Ian-Blockmans/ESPHhome-AIO/1708732876486-708fb2fa-5da7-418b-8b6d-8f5f56bf0609_6.jpg

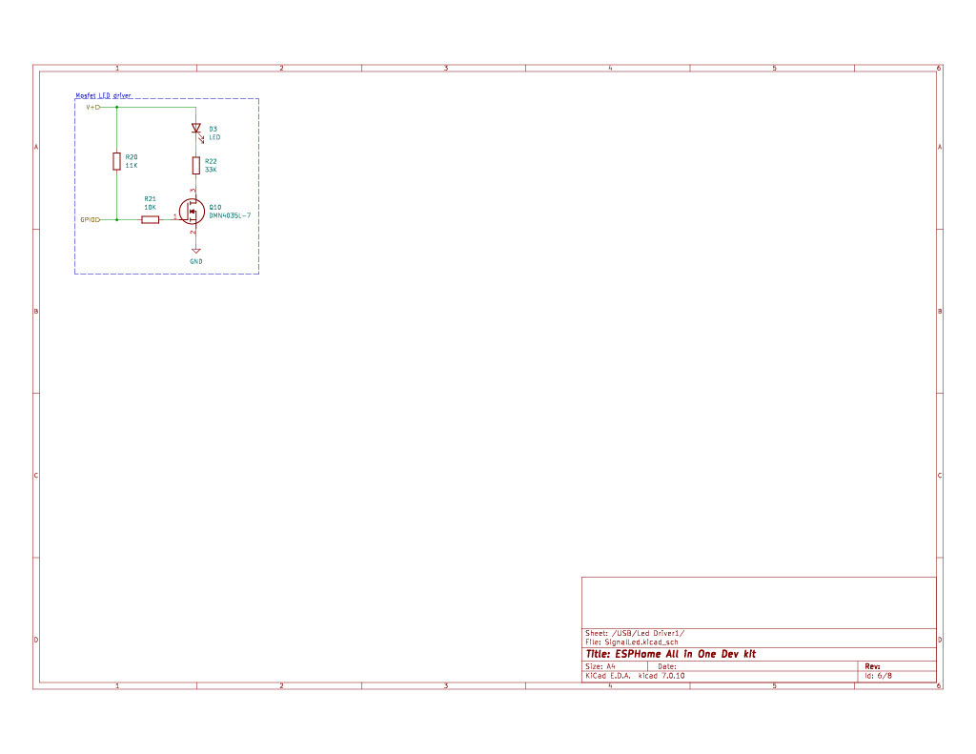
1708732876486-708fb2fa-5da7-418b-8b6d-8f5f56bf0609_6.jpg
