Ian-Blockmans/ESPHhome-AIO/fan-headers.jpg

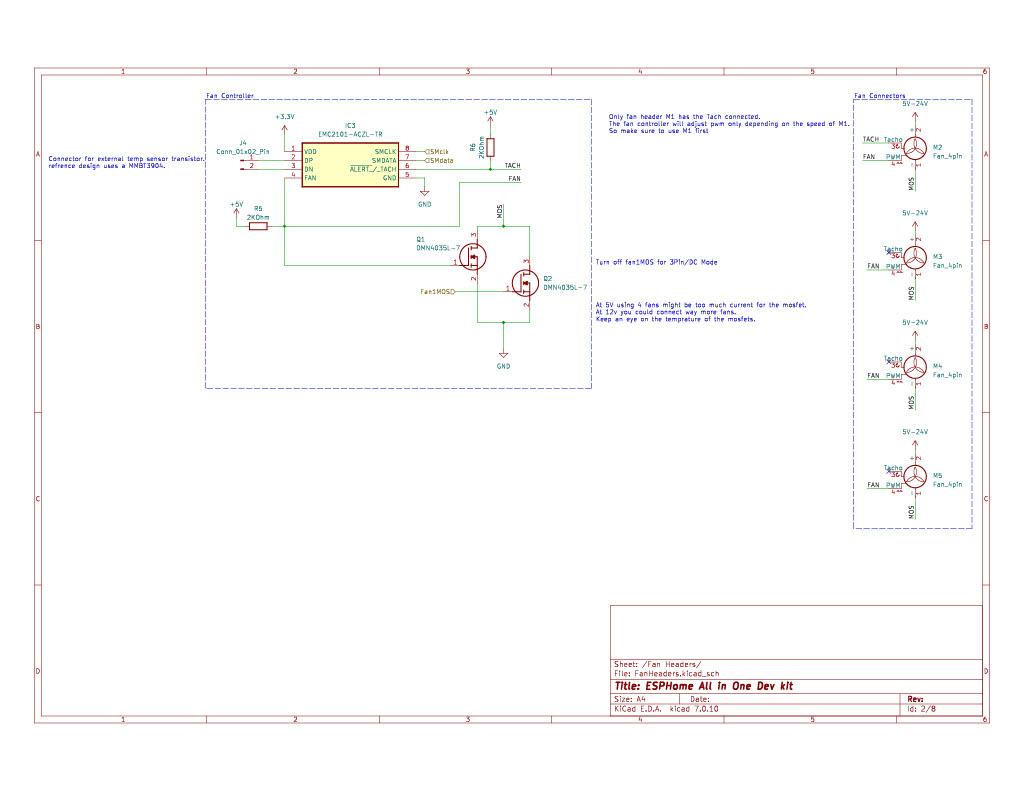
fan-headers.jpg
