Ian-Blockmans/ESPHhome-AIO/rgb.jpg

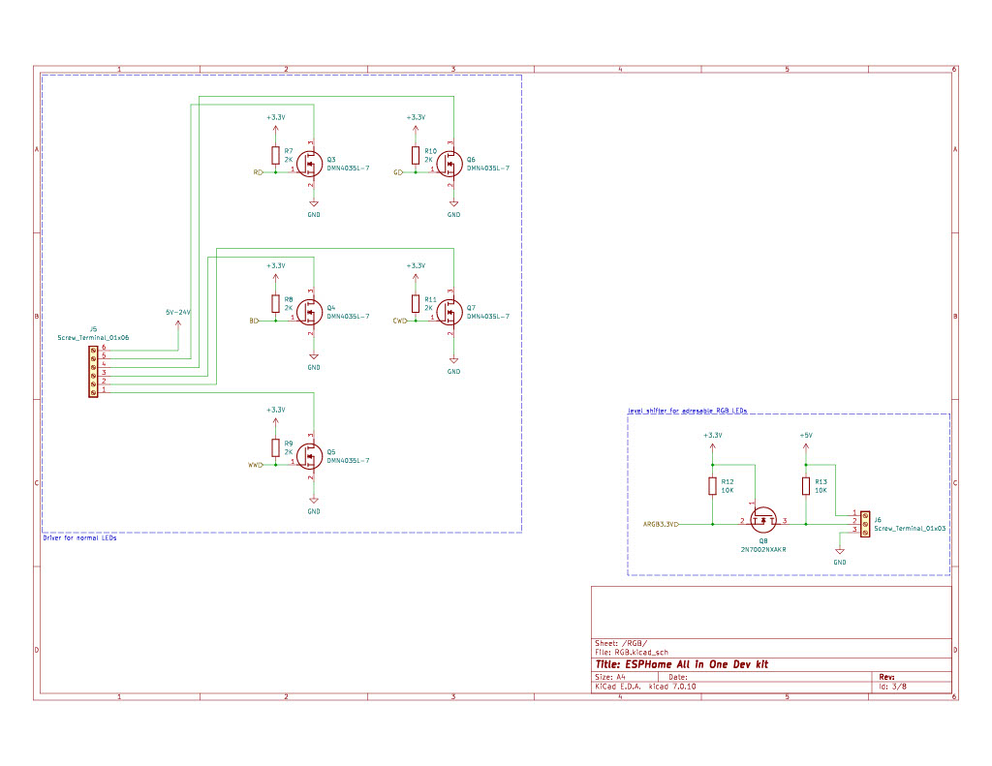
rgb.jpg
