Ian-Blockmans/ESPHhome-AIO/root.jpg

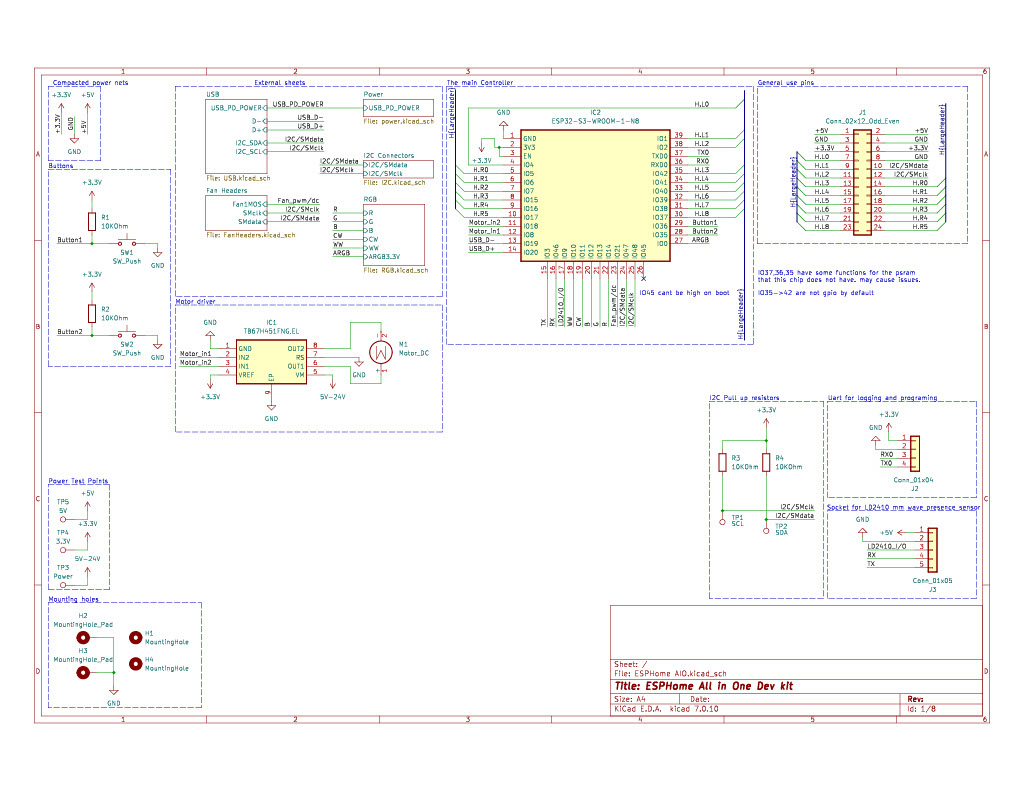
root.jpg
