Ian-Blockmans/ESPHhome-AIO/usb-c.jpg

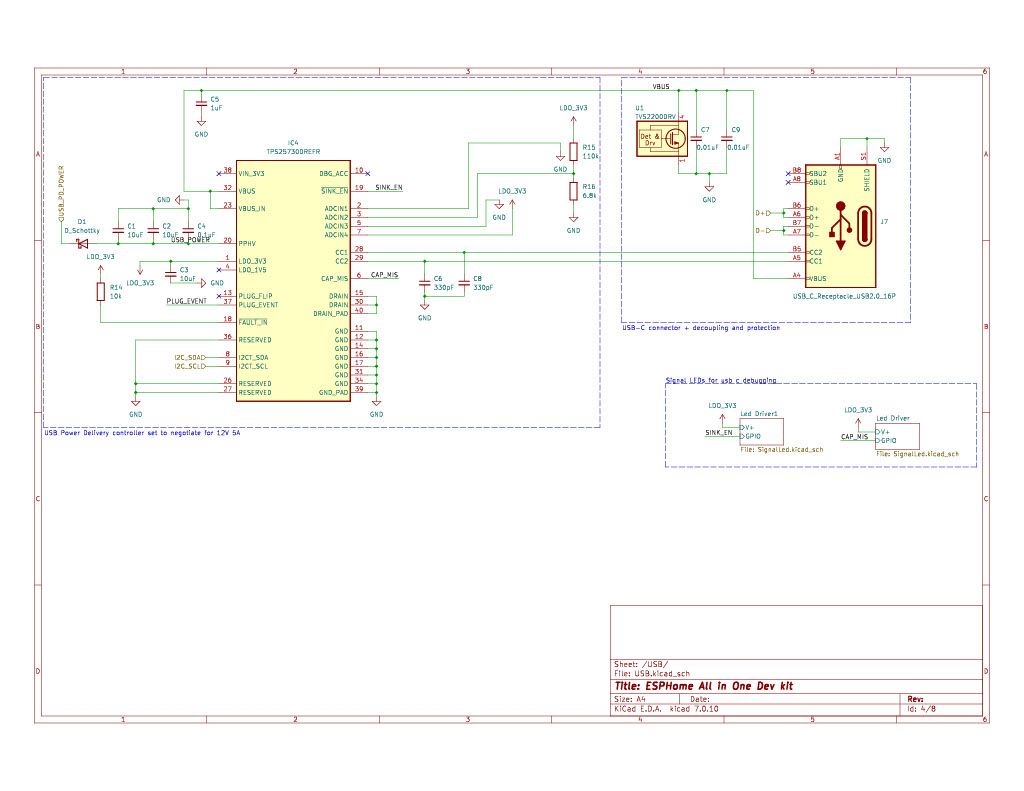
usb-c.jpg
