Ian-Blockmans/ESPHhome-AIO/KiCad Schematics and pcb/ESPHome AIO.kicad_pcb

## KiCad design KiCad Schematics and pcb/ESPHome AIO.kicad_pcb (2024-07-17)

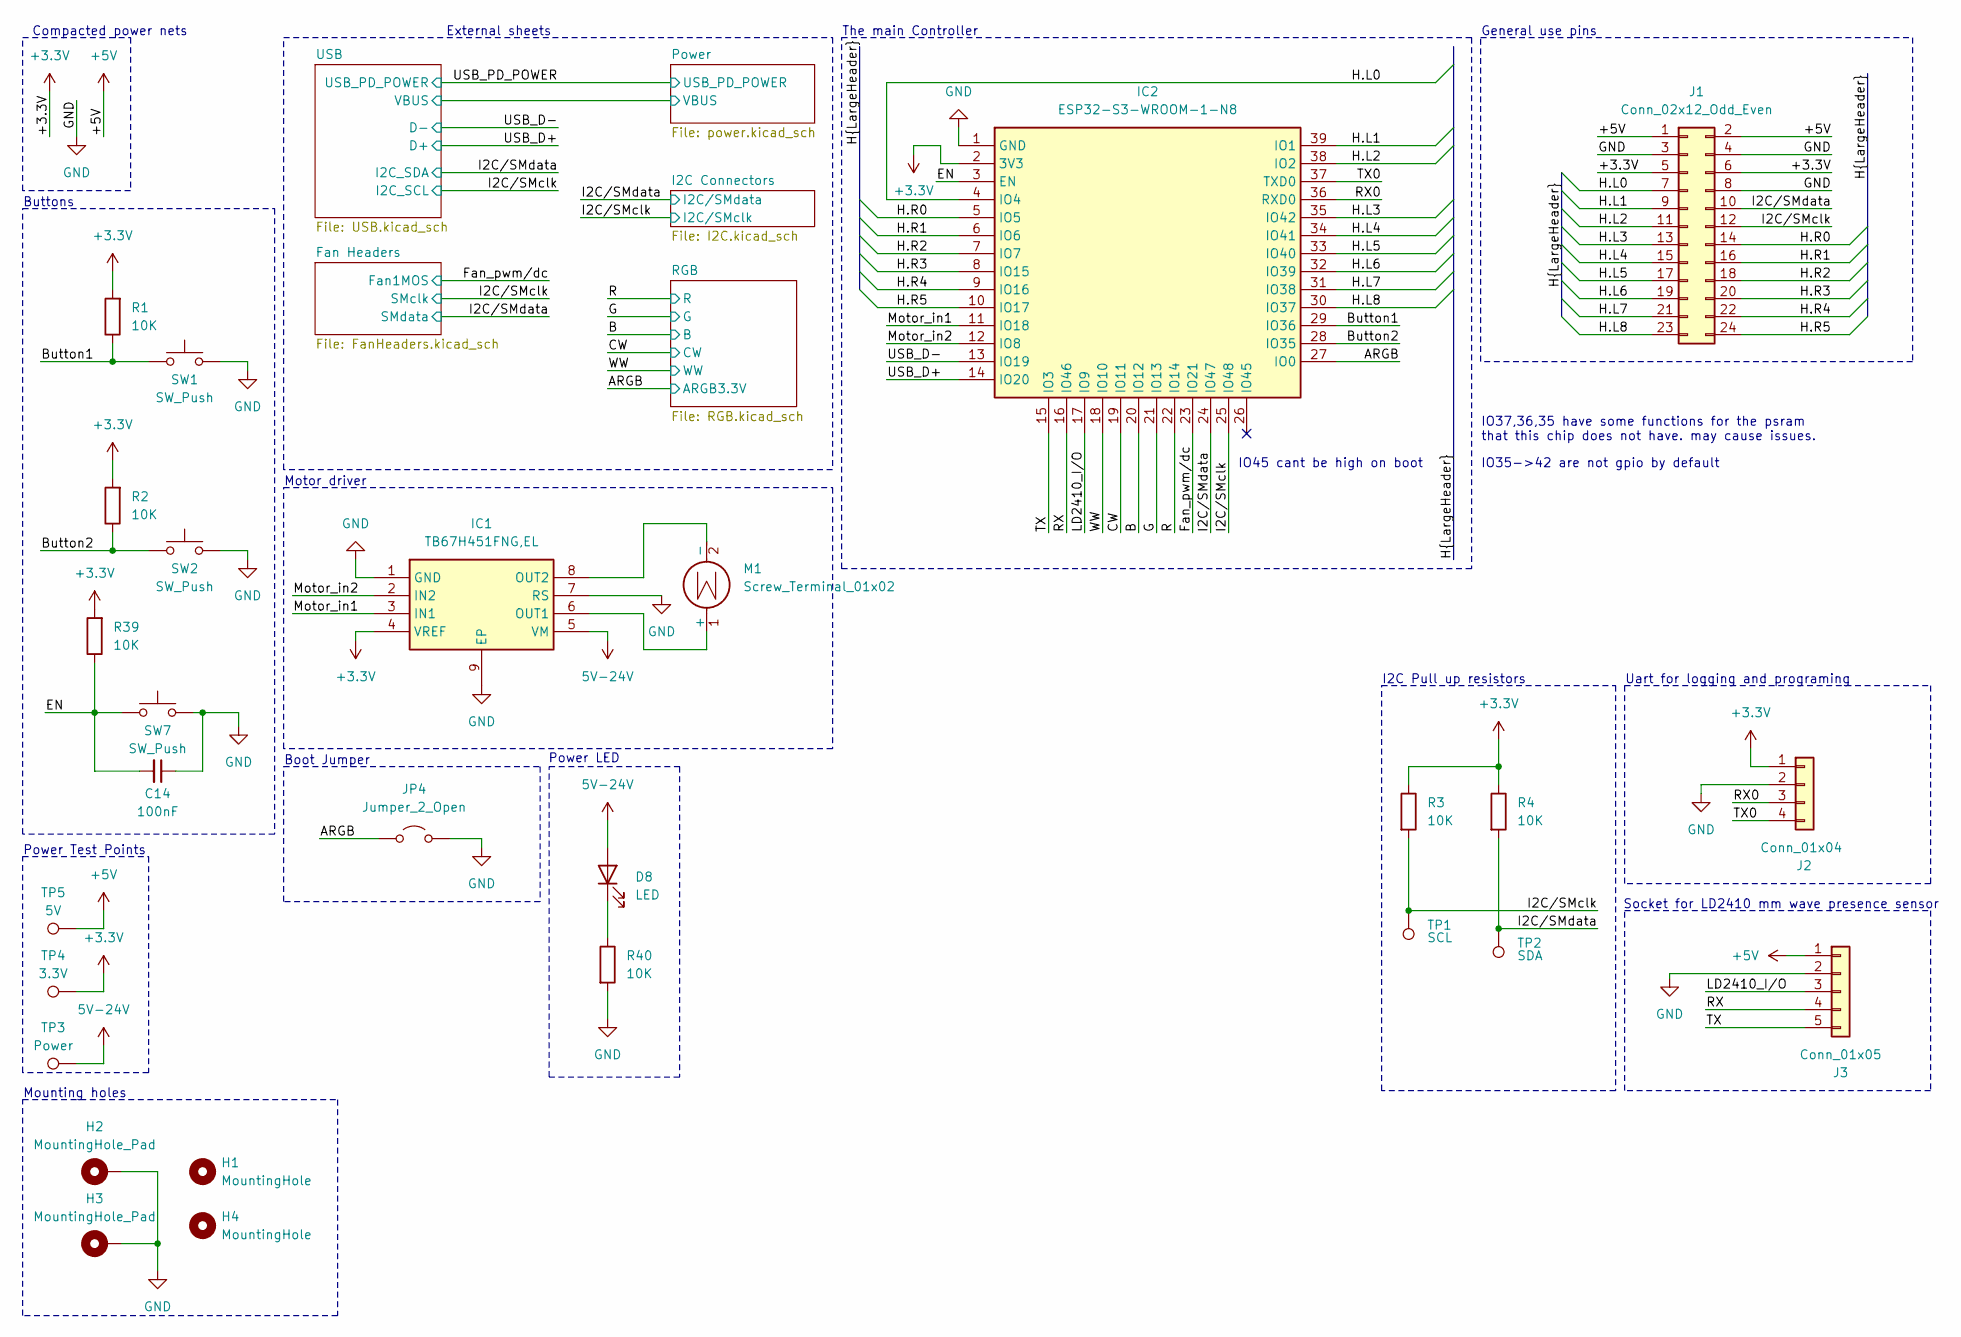
[picture p24: schematic ESPHome AIO.kicad_sch, ESPHome All in One Dev kit]

Parts:
C14: 100nF; C_0805_2012Metric
D8: LED; LED_0805_2012Metric
H1, H4: MountingHole; MountingHole_4.3mm_M4
H2, H3: MountingHole_Pad; MountingHole_4.3mm_M4_Pad
IC1: TB67H451FNG,EL; SOIC127P600X170-9N; Manufacturer_Part_Number TB67H451FNG,EL; Mouser Part Number 757-TB67H451FNGEL
IC2: ESP32-S3-WROOM-1-N8; ESP32S3WROOM1N8R8; Manufacturer_Part_Number ESP32-S3-WROOM-1-N8R8; Mouser Part Number 356-EP32S3WROOM1N8R8
J1: Conn_02x12_Odd_Even; PinHeader_2x12_P2.54mm_Vertical; LCSC C5383110
J2: Conn_01x04; PinHeader_1x04_P2.54mm_Vertical; LCSC C6332197
J3: Conn_01x05; PinHeader_1x05_P2.54mm_Vertical; LCSC C2935899
JP4: Jumper_2_Open; PinHeader_1x02_P2.54mm_Vertical
M1: Screw_Terminal_01x02; PhoenixContact_MSTBA_2,5_2-G-5,08_1x02_P5.08mm_Horizontal; LCSC C8383
R1, R2, R3, R4, R39, R40: 10K; R_0805_2012Metric; LCSC C17414
SW1, SW2, SW7: SW_Push; SW_PUSH_6mm_H7.3mm; LCSC C7463311
TP1: SCL; TestPoint_Loop_D2.60mm_Drill1.4mm_Beaded
TP2: SDA; TestPoint_Loop_D2.60mm_Drill1.4mm_Beaded
TP3: Power; TestPoint_Loop_D2.60mm_Drill1.4mm_Beaded
TP4: 3.3V; TestPoint_Loop_D2.60mm_Drill1.4mm_Beaded
TP5: 5V; TestPoint_Loop_D2.60mm_Drill1.4mm_Beaded

Connections:
5V-24V: D8.2 (A), IC1.5 (VM), TP3.1; also elsewhere on the board
+3.3V: IC1.4 (VREF), IC2.2 (3V3), J1.5, J1.6, J2.1, R1.2, R2.2, R3.1, R4.1, R39.2, TP4.1; also elsewhere on the board
+5V: J1.1, J1.2, J3.1, TP5.1; also elsewhere on the board
/ARGB: IC2.27 (IO0), JP4.1 (A); also elsewhere on the board
/B: IC2.20 (IO12); also elsewhere on the board
/Button1: IC2.29 (IO36), R1.1, SW1.1
/Button2: IC2.28 (IO35), R2.1, SW2.1
/CW: IC2.19 (IO11); also elsewhere on the board
/EN: C14.2, IC2.3 (EN), R39.1, SW7.1
/Fan_pwm/dc: IC2.23 (IO21); also elsewhere on the board
/G: IC2.21 (IO13); also elsewhere on the board
/H.L0: IC2.4 (IO4), J1.7
/H.L1: IC2.39 (IO1), J1.9
/H.L2: IC2.38 (IO2), J1.11
/H.L3: IC2.35 (IO42), J1.13
/H.L4: IC2.34 (IO41), J1.15
/H.L5: IC2.33 (IO40), J1.17
/H.L6: IC2.32 (IO39), J1.19
/H.L7: IC2.31 (IO38), J1.21
/H.L8: IC2.30 (IO37), J1.23
/H.R0: IC2.5 (IO5), J1.14
/H.R1: IC2.6 (IO6), J1.16
/H.R2: IC2.7 (IO7), J1.18
/H.R3: IC2.8 (IO15), J1.20
/H.R4: IC2.9 (IO16), J1.22
/H.R5: IC2.10 (IO17), J1.24
/I2C/SMclk: IC2.25 (IO48), J1.12, R3.2, TP1.1; also elsewhere on the board
/I2C/SMdata: IC2.24 (IO47), J1.10, R4.2, TP2.1; also elsewhere on the board
/LD2410_I/O: IC2.17 (IO9), J3.3
/Motor_in1: IC1.3 (IN1), IC2.11 (IO18)
/Motor_in2: IC1.2 (IN2), IC2.12 (IO8)
/R: IC2.22 (IO14); also elsewhere on the board
/RX: IC2.16 (IO46), J3.4
/RX0: IC2.36 (RXD0), J2.3
/TX: IC2.15 (IO3), J3.5
/TX0: IC2.37 (TXD0), J2.4
/USB_D+: IC2.14 (IO20); also elsewhere on the board
/USB_D-: IC2.13 (IO19); also elsewhere on the board
/WW: IC2.18 (IO10); also elsewhere on the board
unnamed: D8.1 (K), R40.1
unnamed: IC1.6 (OUT1), M1.1 (+)
unnamed: IC1.8 (OUT2), M1.2 (-)

Notes on the sheet:
Compacted power nets
Power LED
Boot Jumper
External sheets
Socket for LD2410 mm wave presence sensor
General use pins
IO45 cant be high on boot
The main Controller
Mounting holes
Power Test Points
Uart for logging and programing
I2C Pull up resistors
IO37,36,35 have some functions for the psram that this chip does not have. may cause issues.
Buttons
Motor driver
IO35->42 are not gpio by default

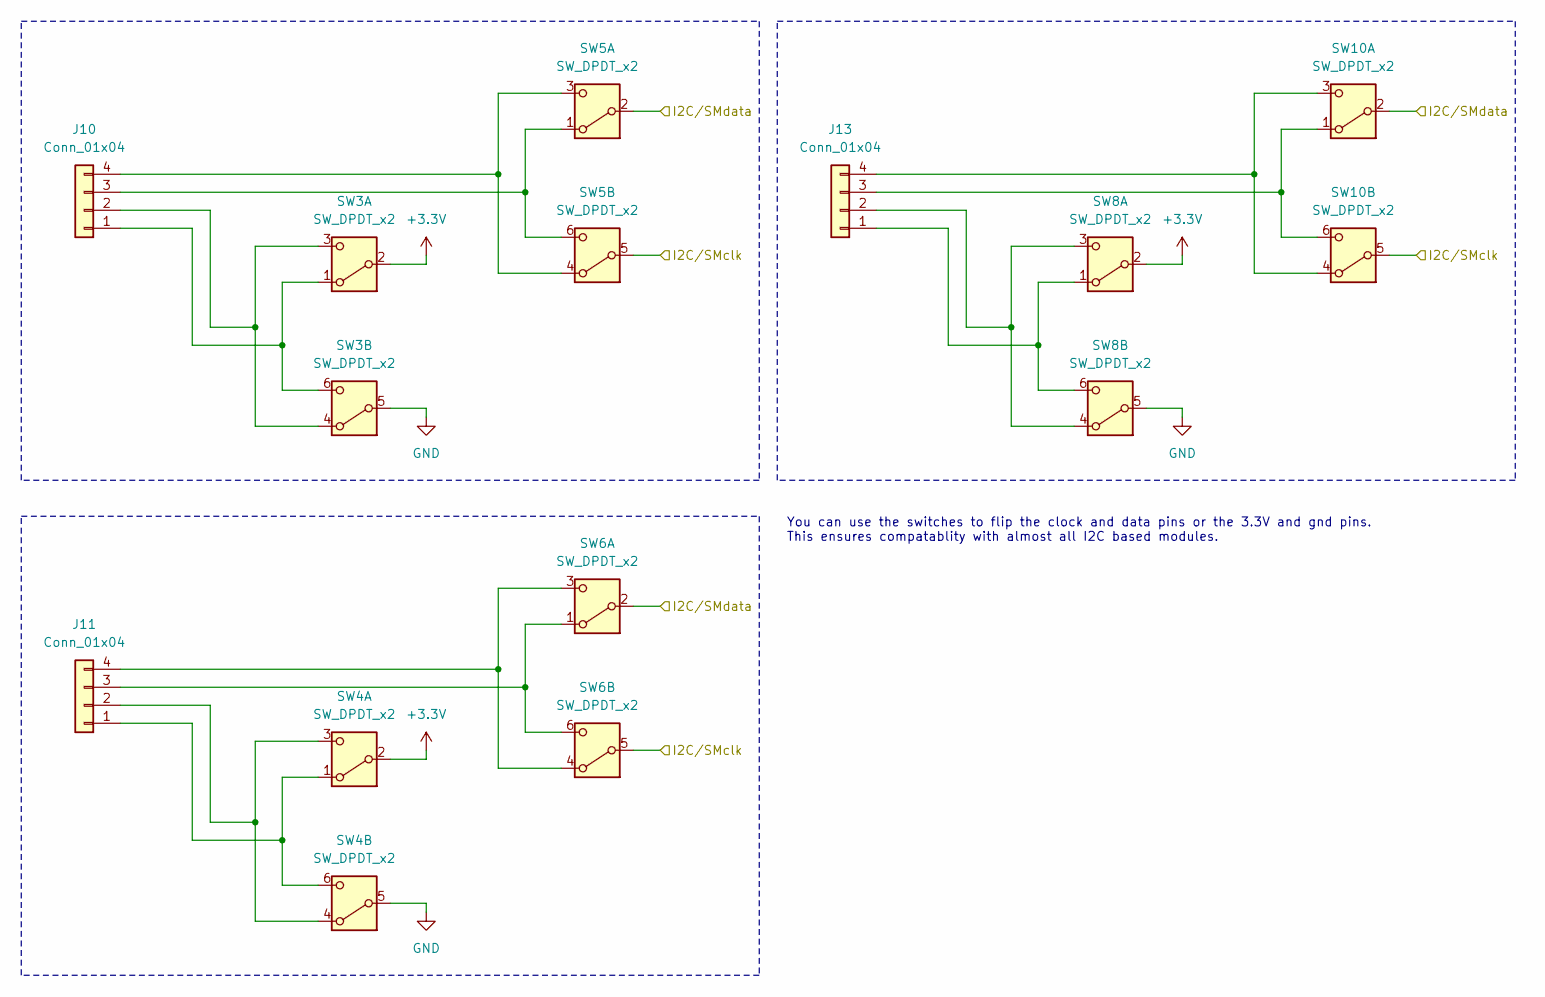
[picture p25: schematic I2C.kicad_sch, ESPHome All in One Dev kit]

Parts:
J10, J11, J13: Conn_01x04; PinHeader_1x04_P2.54mm_Vertical
SW3, SW4, SW5, SW6, SW8, SW10: SW_DPDT_x2; SW_CK_JS202011CQN_DPDT_Straight

Connections:
+3.3V: SW3.2 (B), SW4.2 (B), SW8.2 (B); also elsewhere on the board
/I2C/SMclk: SW5.5 (B), SW6.5 (B), SW10.5 (B); also elsewhere on the board
/I2C/SMdata: SW5.2 (B), SW6.2 (B), SW10.2 (B); also elsewhere on the board
unnamed: J10.1, SW3.1 (A), SW3.6 (C)
unnamed: J10.2, SW3.3 (C), SW3.4 (A)
unnamed: J10.3, SW5.1 (A), SW5.6 (C)
unnamed: J10.4, SW5.3 (C), SW5.4 (A)
unnamed: J11.1, SW4.1 (A), SW4.6 (C)
unnamed: J11.2, SW4.3 (C), SW4.4 (A)
unnamed: J11.3, SW6.1 (A), SW6.6 (C)
unnamed: J11.4, SW6.3 (C), SW6.4 (A)
unnamed: J13.1, SW8.1 (A), SW8.6 (C)
unnamed: J13.2, SW8.3 (C), SW8.4 (A)
unnamed: J13.3, SW10.1 (A), SW10.6 (C)
unnamed: J13.4, SW10.3 (C), SW10.4 (A)

Notes on the sheet:
You can use the switches to flip the clock and data pins or the 3.3V and gnd pins. This ensures compatablity with almost all I2C based modules.

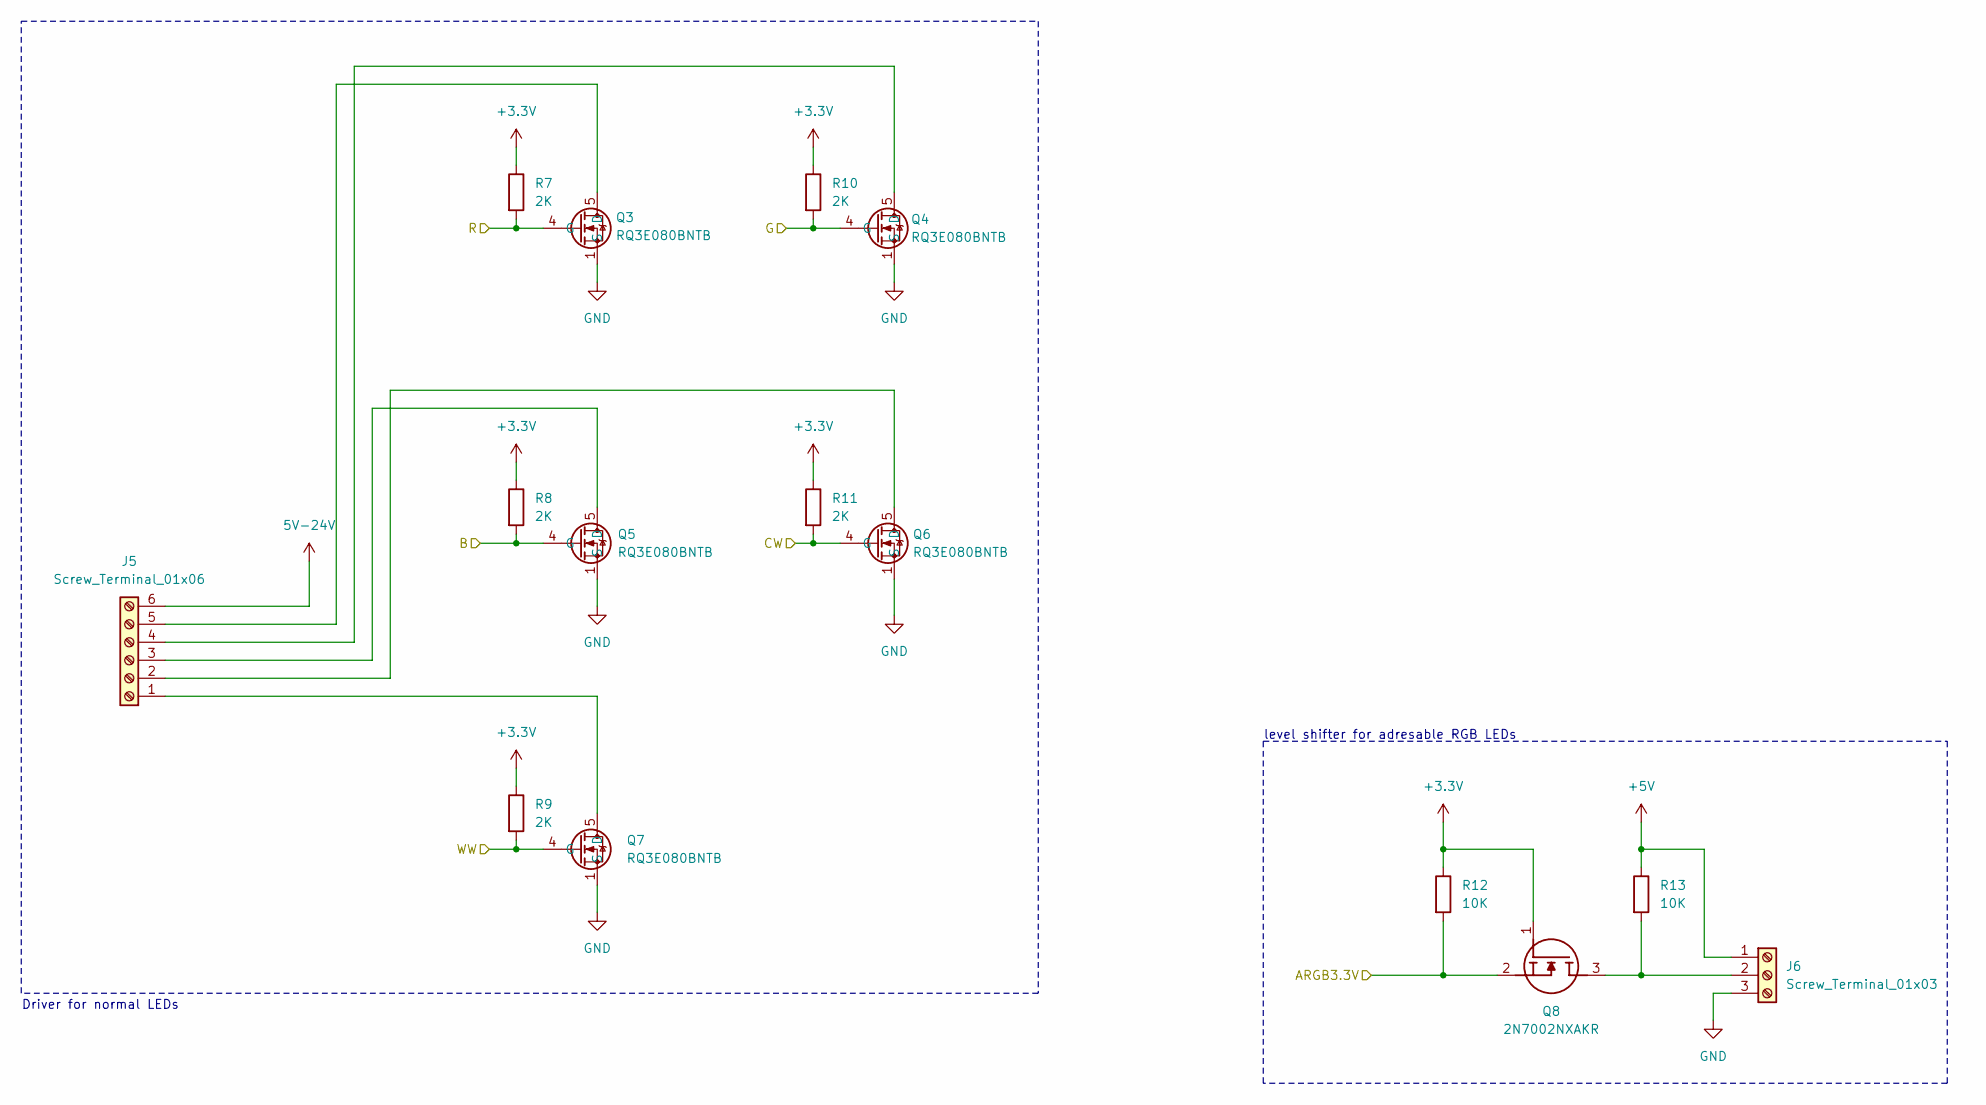
[picture p26: schematic RGB.kicad_sch, ESPHome All in One Dev kit]

Parts:
J5: Screw_Terminal_01x06; PhoenixContact_MSTBA_2,5_6-G-5,08_1x06_P5.08mm_Horizontal
J6: Screw_Terminal_01x03; PhoenixContact_MSTBA_2,5_3-G-5,08_1x03_P5.08mm_Horizontal
Q3, Q4, Q5, Q6, Q7: RQ3E080BNTB; Manufacturer_Part_Number RQ3E080BNTB; Mouser Part Number 755-RQ3E080BNTB
Q8: 2N7002NXAKR; SOT95P230X110-3N; Manufacturer_Part_Number 2N7002NXAKR; Mouser Part Number 771-2N7002NXAKR
R7, R8, R9, R10, R11: 2K; R_0805_2012Metric
R12, R13: 10K; R_0805_2012Metric

Connections:
5V-24V: J5.6; also elsewhere on the board
+3.3V: Q8.1 (G), R7.1, R8.1, R9.1, R10.1, R11.1, R12.1; also elsewhere on the board
+5V: J6.1, R13.1; also elsewhere on the board
/ARGB: Q8.2 (S), R12.2; also elsewhere on the board
/B: Q5.4 (G), R8.2; also elsewhere on the board
/CW: Q6.4 (G), R11.2; also elsewhere on the board
/G: Q4.4 (G), R10.2; also elsewhere on the board
/R: Q3.4 (G), R7.2; also elsewhere on the board
/WW: Q7.4 (G), R9.2; also elsewhere on the board
unnamed: J5.1, Q7.5 (D), Q7.6 (DRAIN_2), Q7.7 (DRAIN_3), Q7.8 (DRAIN_4), Q7.9 (DRAIN_5)
unnamed: J5.2, Q6.5 (D), Q6.6 (DRAIN_2), Q6.7 (DRAIN_3), Q6.8 (DRAIN_4), Q6.9 (DRAIN_5)
unnamed: J5.3, Q5.5 (D), Q5.6 (DRAIN_2), Q5.7 (DRAIN_3), Q5.8 (DRAIN_4), Q5.9 (DRAIN_5)
unnamed: J5.4, Q4.5 (D), Q4.6 (DRAIN_2), Q4.7 (DRAIN_3), Q4.8 (DRAIN_4), Q4.9 (DRAIN_5)
unnamed: J5.5, Q3.5 (D), Q3.6 (DRAIN_2), Q3.7 (DRAIN_3), Q3.8 (DRAIN_4), Q3.9 (DRAIN_5)
unnamed: J6.2, Q8.3 (D), R13.2

Notes on the sheet:
level shifter for adresable RGB LEDs
Driver for normal LEDs

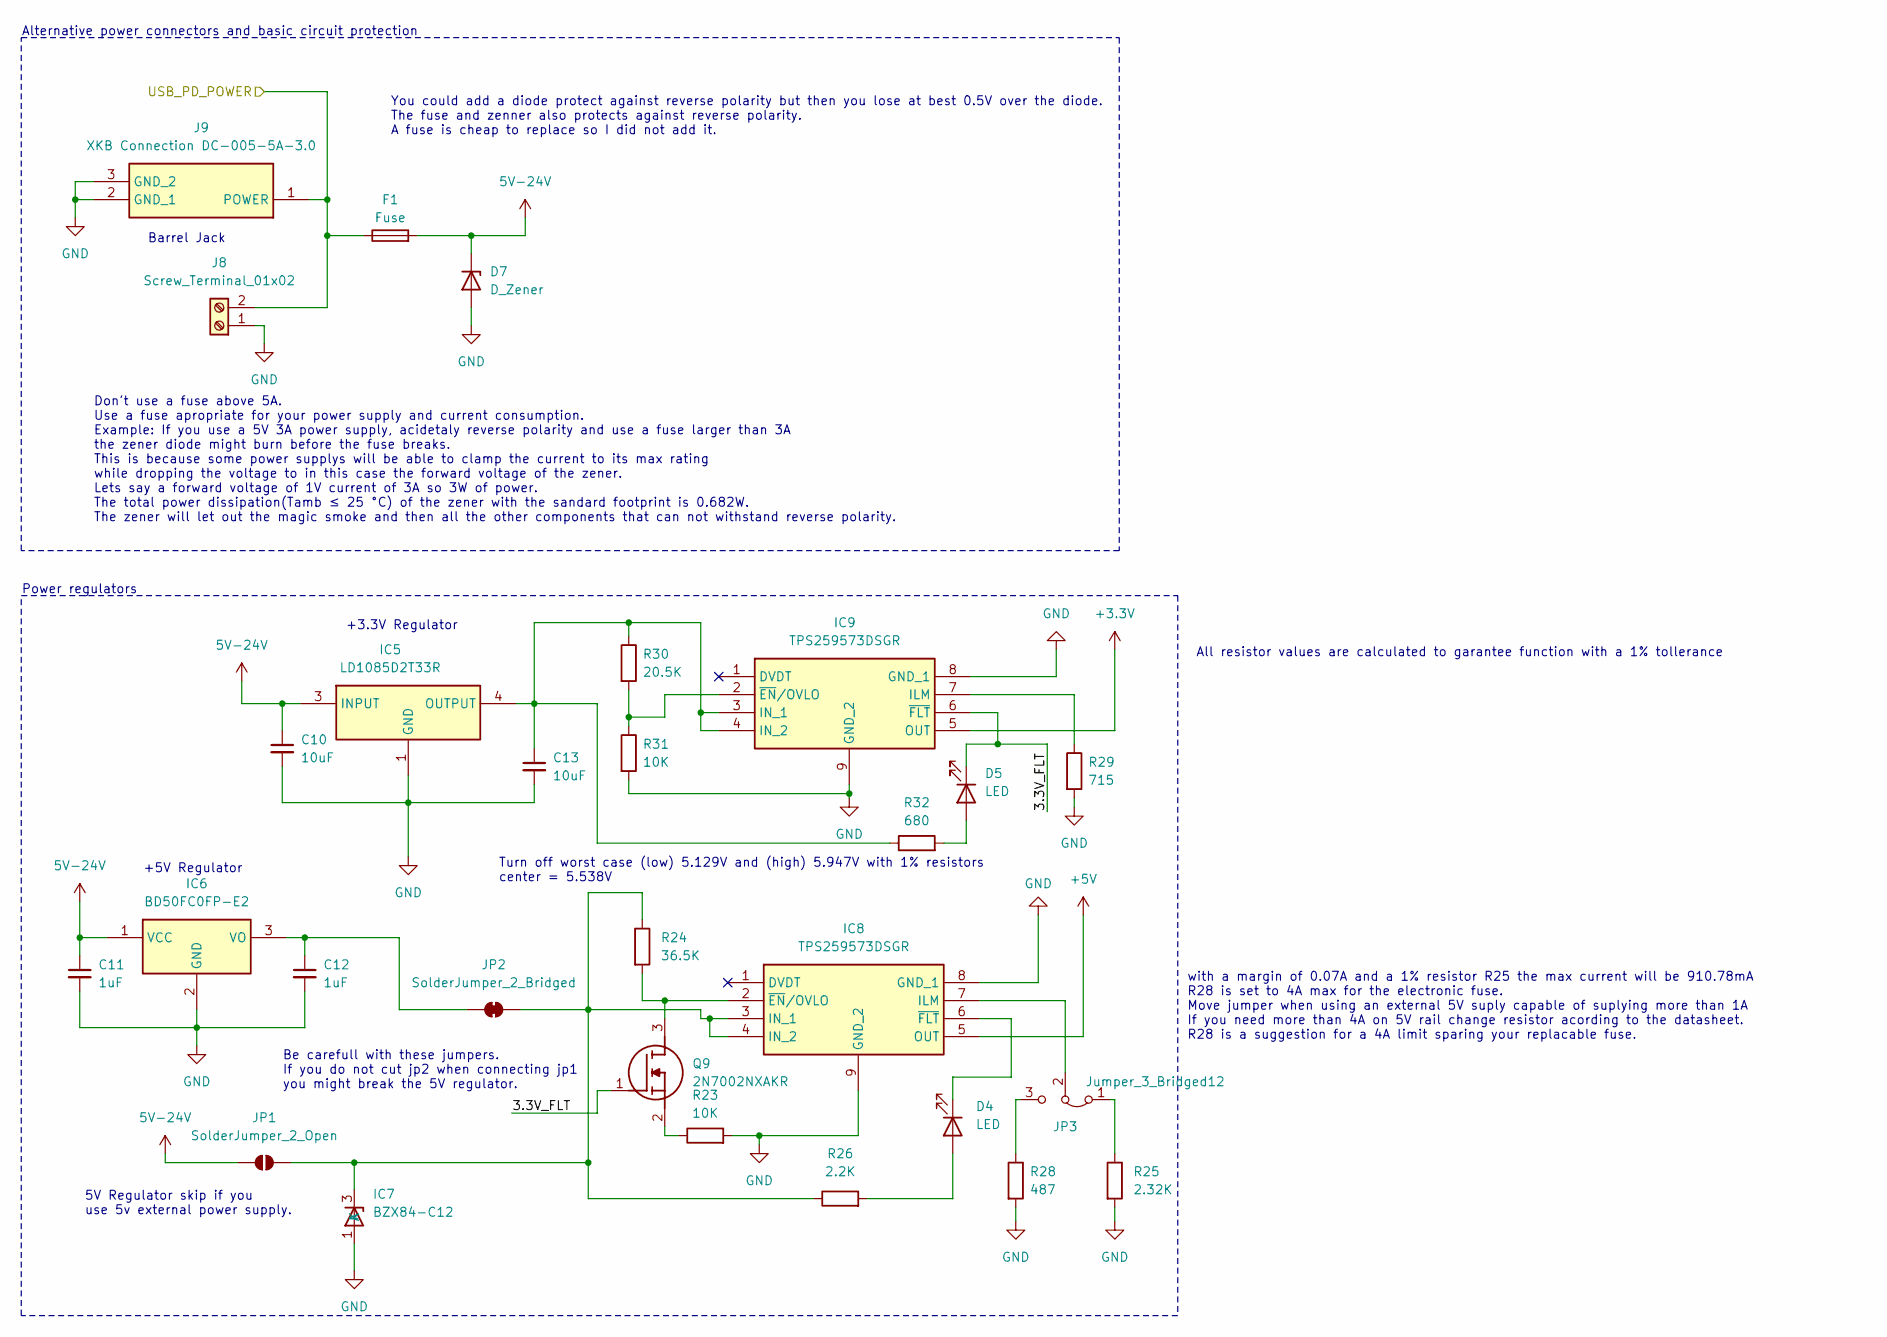
[picture p27: schematic power.kicad_sch, ESPHome All in One Dev kit]

Parts:
C10, C13: 10uF; C_0805_2012Metric
C11, C12: 1uF; C_0805_2012Metric
D4, D5: LED; LED_0805_2012Metric
D7: D_Zener; HPZRC28QX
F1: Fuse; Fuseholder_Littelfuse_Nano2_154x
IC5: LD1085D2T33R; Manufacturer_Part_Number LD1085D2T33R; Mouser Part Number 511-LD1085D2T33-TR
IC6: BD50FC0FP-E2; BD50FC0FPE2; Manufacturer_Part_Number BD50FC0FP-E2; Mouser Part Number 755-BD50FC0FP-E2
IC7: BZX84-C12; SOT95P230X110-3N; Manufacturer_Part_Number BZX84-C12; Mouser Part Number N/A
IC8, IC9: TPS259573DSGR; SON50P200X200X80-9N; Manufacturer_Part_Number TPS259573DSGR; Mouser Part Number 595-TPS259573DSGR
J8: Screw_Terminal_01x02; PhoenixContact_MSTBA_2,5_2-G-5,08_1x02_P5.08mm_Horizontal
J9: XKB Connection DC-005-5A-3.0; BarrelJack_Horizontal; Manufacturer_Part_Number 694106301002; Mouser Part Number 710-694106301002
JP1: SolderJumper_2_Open; SolderJumper-2_P1.3mm_Open_TrianglePad1.0x1.5mm
JP2: SolderJumper_2_Bridged; SolderJumper-2_P1.3mm_Open_TrianglePad1.0x1.5mm
JP3: Jumper_3_Bridged12; PinHeader_1x03_P2.54mm_Vertical
Q9: 2N7002NXAKR; SOT95P230X110-3N; Manufacturer_Part_Number 2N7002NXAKR; Mouser Part Number 771-2N7002NXAKR
R23, R31: 10K; R_0805_2012Metric
R24: 36.5K; R_0805_2012Metric
R25: 2.32K; R_0805_2012Metric
R26: 2.2K; R_0805_2012Metric
R28: 487; R_0805_2012Metric
R29: 715; R_0805_2012Metric
R30: 20.5K; R_0805_2012Metric
R32: 680; R_0805_2012Metric

Connections:
5V-24V: C10.1, C11.1, D7.1 (K), F1.2, IC5.3 (INPUT), IC6.1 (VCC), JP1.1 (A); also elsewhere on the board
+3.3V: IC9.5 (OUT); also elsewhere on the board
+5V: IC8.5 (OUT); also elsewhere on the board
/Power/3.3V_FLT: D5.1 (K), IC9.6 (~FLT), Q9.1 (G)
/USB_PD_POWER: F1.1, J8.2, J9.1 (POWER); also elsewhere on the board
unnamed: D4.1 (K), IC8.6 (~FLT)
unnamed: D5.2 (A), R32.2
unnamed: C13.1, IC5.4 (OUTPUT), IC9.3 (IN_1), IC9.4 (IN_2), R30.1, R32.1
unnamed: C12.1, IC6.3 (VO), JP2.1 (A)
unnamed: IC7.3 (K), IC8.3 (IN_1), IC8.4 (IN_2), JP1.2 (B), JP2.2 (B), R24.1, R26.1
unnamed: IC8.7 (ILM), JP3.2 (C)
unnamed: IC8.2 (~EN/OVLO), Q9.3 (D), R24.2
unnamed: IC9.7 (ILM), R29.1
unnamed: IC9.2 (~EN/OVLO), R30.2, R31.1
unnamed: JP3.1 (A), R25.1
unnamed: JP3.3 (B), R28.1
unnamed: Q9.2 (S), R23.1

Notes on the sheet:
Barrel Jack
You could add a diode protect against reverse polarity but then you lose at best 0.5V over the diode. The fuse and zenner also protects against reverse polarity. A fuse is cheap to replace so I did not add it.
Alternative power connectors and basic circuit protection
+3.3V Regulator
All resistor values are calculated to garantee function with a 1% tollerance
Power regulators
Be carefull with these jumpers. If you do not cut jp2 when connecting jp1 you might break the 5V regulator.
with a margin of 0.07A and a 1% resistor R25 the max current will be 910.78mA R28 is set to 4A max for the electronic fuse. Move jumper when using an external 5V suply capable of suplying more than 1A If you need more than 4A on 5V rail change resistor acording to the datasheet. R28 is a suggestion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
Turn off worst case (low) 5.129V and (high) 5.947V with 1% resistors center = 5.538V
5V Regulator skip if you use 5v external power supply.
+5V Regulator
Don't use a fuse above 5A. Use a fuse apropriate for your power supply and current consumption. Example: If you use a 5V 3A power supply, acidetaly reverse polarity and use a fuse larger than 3A the zener diode might burn before the fuse breaks. This is because some power supplys will be able to cl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

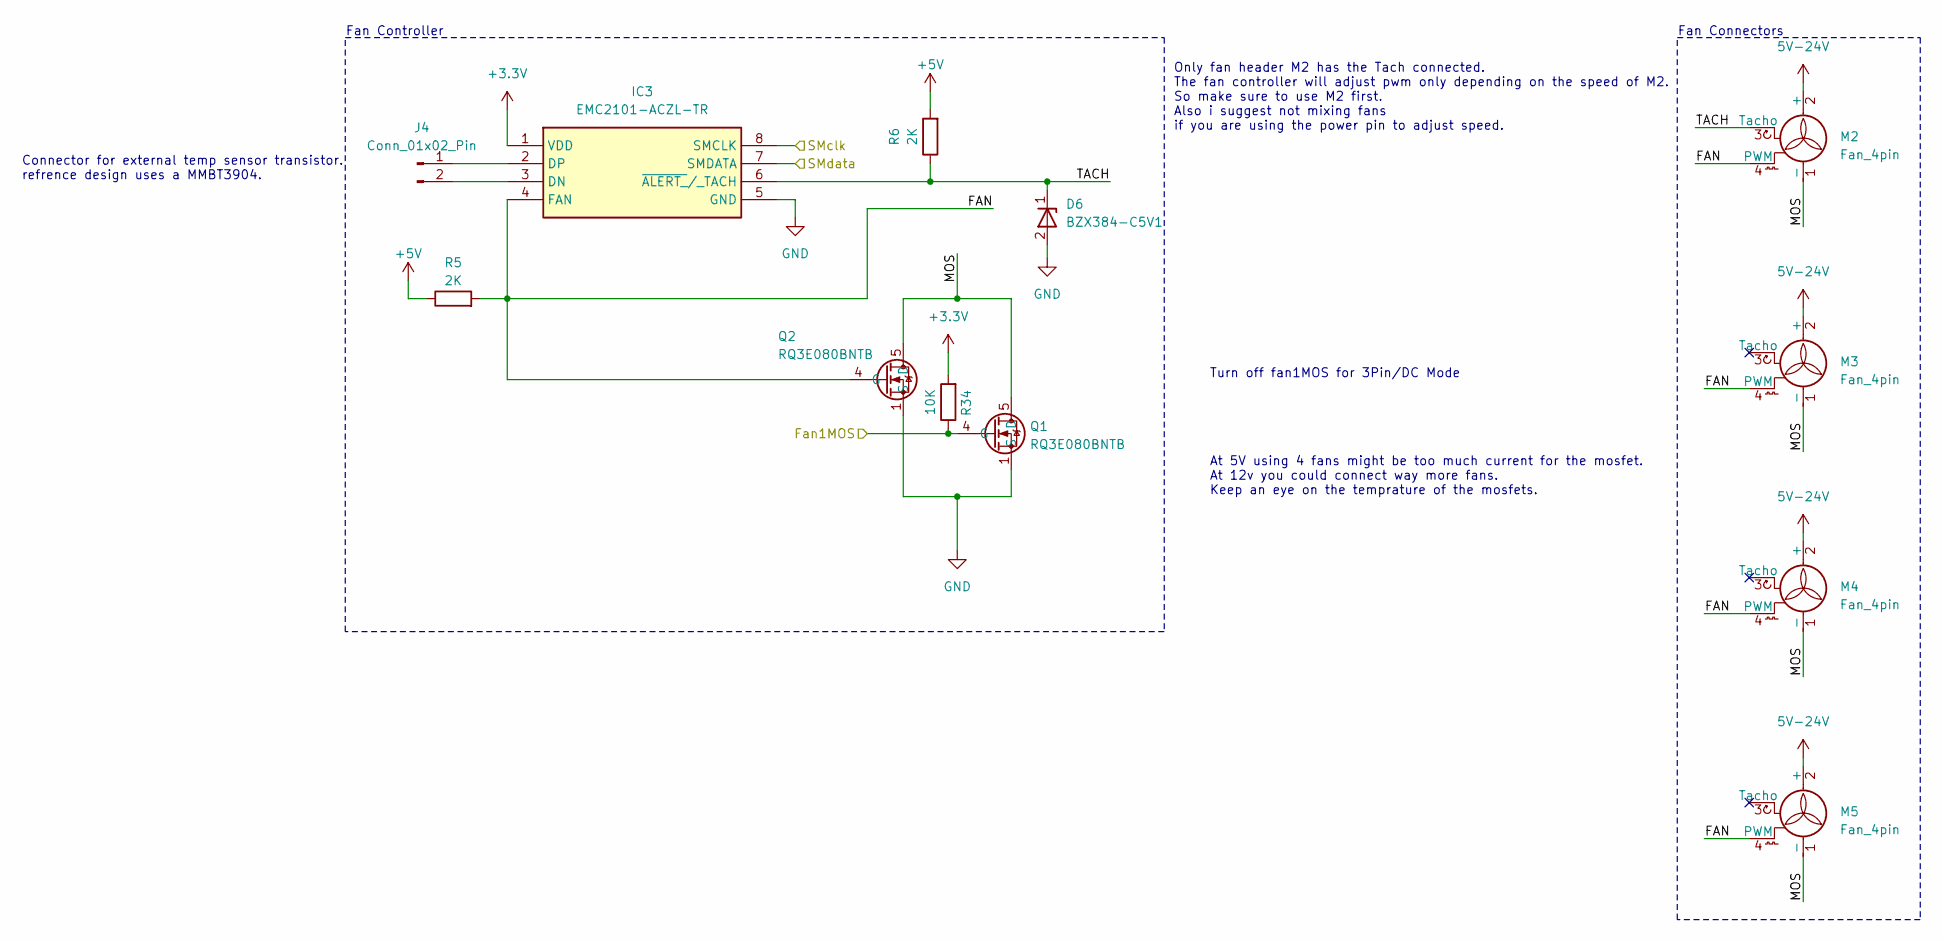
[picture p28: schematic FanHeaders.kicad_sch, ESPHome All in One Dev kit]

Parts:
D6: BZX384-C5V1; SOD2512X110N; Manufacturer_Part_Number BZX384-C5V1; Mouser Part Number N/A
IC3: EMC2101-ACZL-TR; SOP65P490X110-8N; Manufacturer_Part_Number EMC2101-ACZL-TR; Mouser Part Number 886-EMC2101-ACZL-TR
J4: Conn_01x02_Pin; JST_XH_B2B-XH-A_1x02_P2.50mm_Vertical
M2, M3, M4, M5: Fan_4pin; FanPinHeader_1x04_P2.54mm_Vertical
Q1, Q2: RQ3E080BNTB; Manufacturer_Part_Number RQ3E080BNTB; Mouser Part Number 755-RQ3E080BNTB
R5, R6: 2K; R_0805_2012Metric
R34: 10K; R_0805_2012Metric

Connections:
5V-24V: M2.2 (+), M3.2 (+), M4.2 (+), M5.2 (+); also elsewhere on the board
+3.3V: IC3.1 (VDD), R34.2; also elsewhere on the board
+5V: R5.1, R6.2; also elsewhere on the board
/Fan Headers/FAN: IC3.4 (FAN), M2.4 (PWM), M3.4 (PWM), M4.4 (PWM), M5.4 (PWM), Q2.4 (G), R5.2
/Fan Headers/MOS: M2.1 (-), M3.1 (-), M4.1 (-), M5.1 (-), Q1.5 (D), Q1.6 (DRAIN_2), Q1.7 (DRAIN_3), Q1.8 (DRAIN_4), Q1.9 (DRAIN_5), Q2.5 (D), Q2.6 (DRAIN_2), Q2.7 (DRAIN_3), Q2.8 (DRAIN_4), Q2.9 (DRAIN_5)
/Fan Headers/TACH: D6.1 (K), IC3.6 (~ALERT_/_TACH), M2.3 (Tacho), R6.1
/Fan_pwm/dc: Q1.4 (G), R34.1; also elsewhere on the board
/I2C/SMclk: IC3.8 (SMCLK); also elsewhere on the board
/I2C/SMdata: IC3.7 (SMDATA); also elsewhere on the board
unnamed: IC3.3 (DN), J4.2
unnamed: IC3.2 (DP), J4.1

Notes on the sheet:
Fan Controller
Connector for external temp sensor transistor. refrence design uses a MMBT3904.
Fan Connectors
At 5V using 4 fans might be too much current for the mosfet. At 12v you could connect way more fans. Keep an eye on the temprature of the mosfets.
Only fan header M2 has the Tach connected. The fan controller will adjust pwm only depending on the speed of M2. So make sure to use M2 first. Also i suggest not mixing fans if you are using the power pin to adjust speed.
Turn off fan1MOS for 3Pin/DC Mode

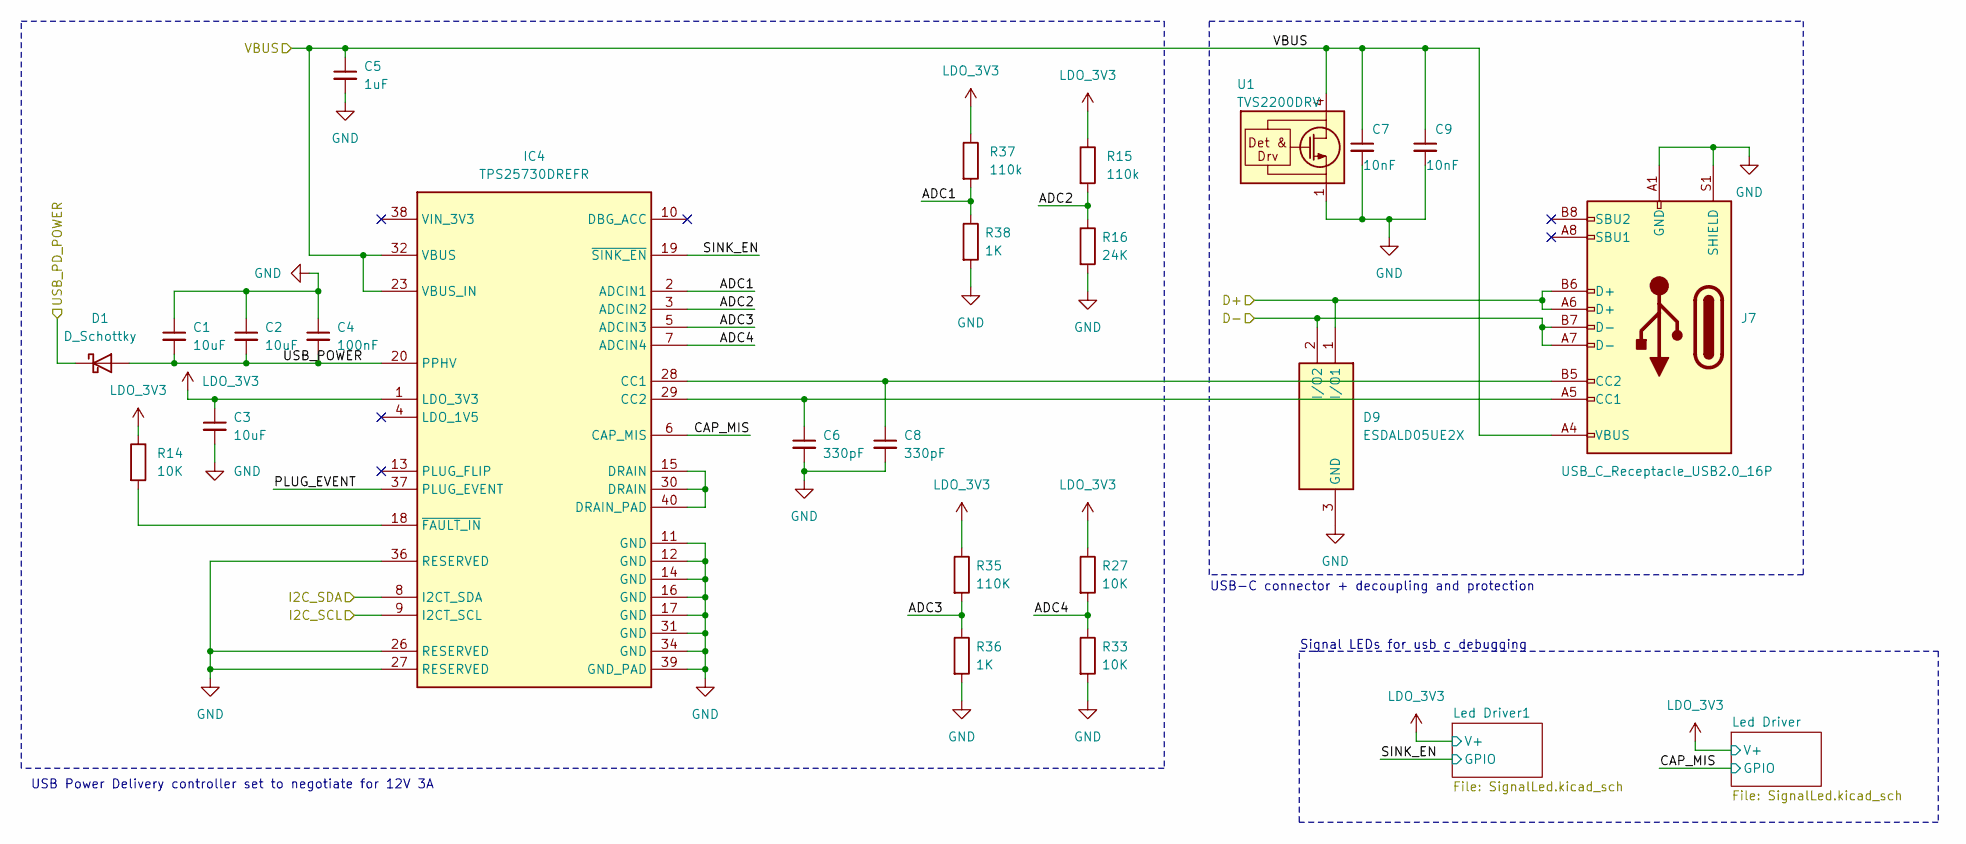
[picture p29: schematic USB.kicad_sch, ESPHome All in One Dev kit]

Parts:
C1, C2, C3: 10uF; C_0805_2012Metric
C4: 100nF; C_0805_2012Metric
C5: 1uF; C_0805_2012Metric
C6, C8: 330pF; C_0805_2012Metric
C7, C9: 10nF; C_0805_2012Metric
D1: D_Schottky; D_SMA
D9: ESDALD05UE2X; SOT95P240X115-3N; Manufacturer_Part_Number ESDALD05UE2X; Mouser Part Number 771-ESDALD05UE2X
IC4: TPS25730DREFR; Manufacturer_Part_Number TPS25730DREFR
J7: USB_C_Receptacle_USB2.0_16P; USB_C_Receptacle_G-Switch_GT-USB-7010ASV
R14, R27, R33: 10K; R_0805_2012Metric
R15, R37: 110k; R_0805_2012Metric
R16: 24K; R_0805_2012Metric
R35: 110K; R_0805_2012Metric
R36, R38: 1K; R_0805_2012Metric
U1: TVS2200DRV; WSON-6-1EP_2x2mm_P0.65mm_EP1x1.6mm

Connections:
/I2C/SMclk: IC4.9 (I2CT_SCL); also elsewhere on the board
/I2C/SMdata: IC4.8 (I2CT_SDA); also elsewhere on the board
/USB/ADC1: IC4.2 (ADCIN1), R37.2, R38.1
/USB/ADC2: IC4.3 (ADCIN2), R15.2, R16.1
/USB/ADC3: IC4.5 (ADCIN3), R35.2, R36.1
/USB/CAP_MIS: IC4.6 (CAP_MIS); also elsewhere on the board
/USB/PLUG_EVENT: IC4.37 (PLUG_EVENT)
/USB/SINK_EN: IC4.19 (~SINK_EN); also elsewhere on the board
/USB/USB_POWER: C1.2, C2.2, C4.2, D1.2 (A), IC4.20 (PPHV), IC4.21 (PPHV), IC4.22 (PPHV), IC4.41 (PPHV)
/USB/VBUS: C5.1, C7.1, C9.1, IC4.23 (VBUS_IN), IC4.24 (VBUS_IN), IC4.25 (VBUS_IN), IC4.32 (VBUS), IC4.33 (VBUS), IC4.42 (VBUS_IN), IC4.43 (VBUS), J7.A4 (VBUS), J7.A9 (VBUS), J7.B4 (VBUS), J7.B9 (VBUS), U1.4 (IN), U1.5 (IN), U1.6 (IN)
/USB_D+: D9.1 (I/O1), J7.A6 (D+), J7.B6 (D+); also elsewhere on the board
/USB_D-: D9.2 (I/O2), J7.A7 (D-), J7.B7 (D-); also elsewhere on the board
/USB_PD_POWER: D1.1 (K); also elsewhere on the board
unnamed: C8.1, IC4.28 (CC1), J7.B5 (CC2)
unnamed: C6.1, IC4.29 (CC2), J7.A5 (CC1)
unnamed: IC4.15 (DRAIN), IC4.30 (DRAIN), IC4.40 (DRAIN_PAD)
unnamed: IC4.18 (~FAULT_IN), R14.2

Notes on the sheet:
USB-C connector + decoupling and protection
Signal LEDs for usb c debugging
USB Power Delivery controller set to negotiate for 12V 3A

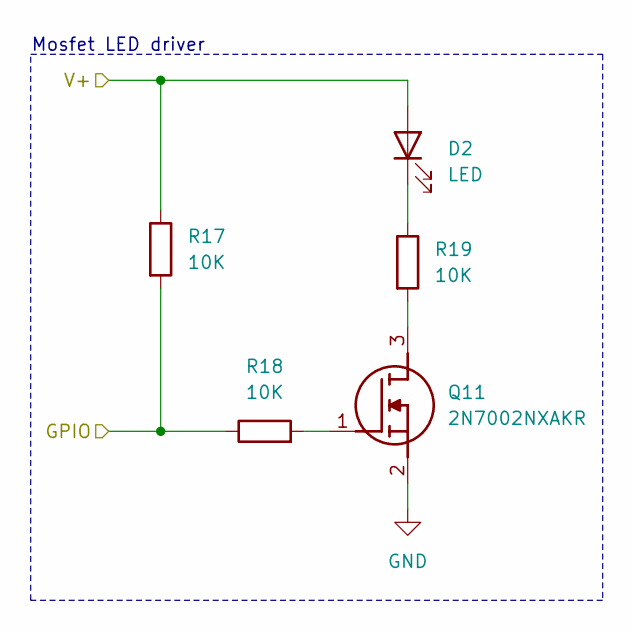
[picture p30: schematic SignalLed.kicad_sch, ESPHome All in One Dev kit]

Parts:
D2: LED; LED_0805_2012Metric
Q11: 2N7002NXAKR; SOT95P230X110-3N; Manufacturer_Part_Number 2N7002NXAKR; Mouser Part Number 771-2N7002NXAKR
R17, R18, R19: 10K; R_0805_2012Metric

Connections:
/USB/CAP_MIS: R17.2, R18.1; also elsewhere on the board
unnamed: D2.1 (K), R19.1
unnamed: Q11.3 (D), R19.2
unnamed: Q11.1 (G), R18.2

Parts of its further copies:
D3: LED; LED_0805_2012Metric
Q12: 2N7002NXAKR; SOT95P230X110-3N; Manufacturer_Part_Number 2N7002NXAKR; Mouser Part Number 771-2N7002NXAKR
R20, R21, R22: 10K; R_0805_2012Metric

Connections of its further copies:
/USB/SINK_EN: R20.2, R21.1; also elsewhere on the board
unnamed: D3.1 (K), R22.1
unnamed: Q12.3 (D), R22.2
unnamed: Q12.1 (G), R21.2

Notes on the sheet:
Mosfet LED driver

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
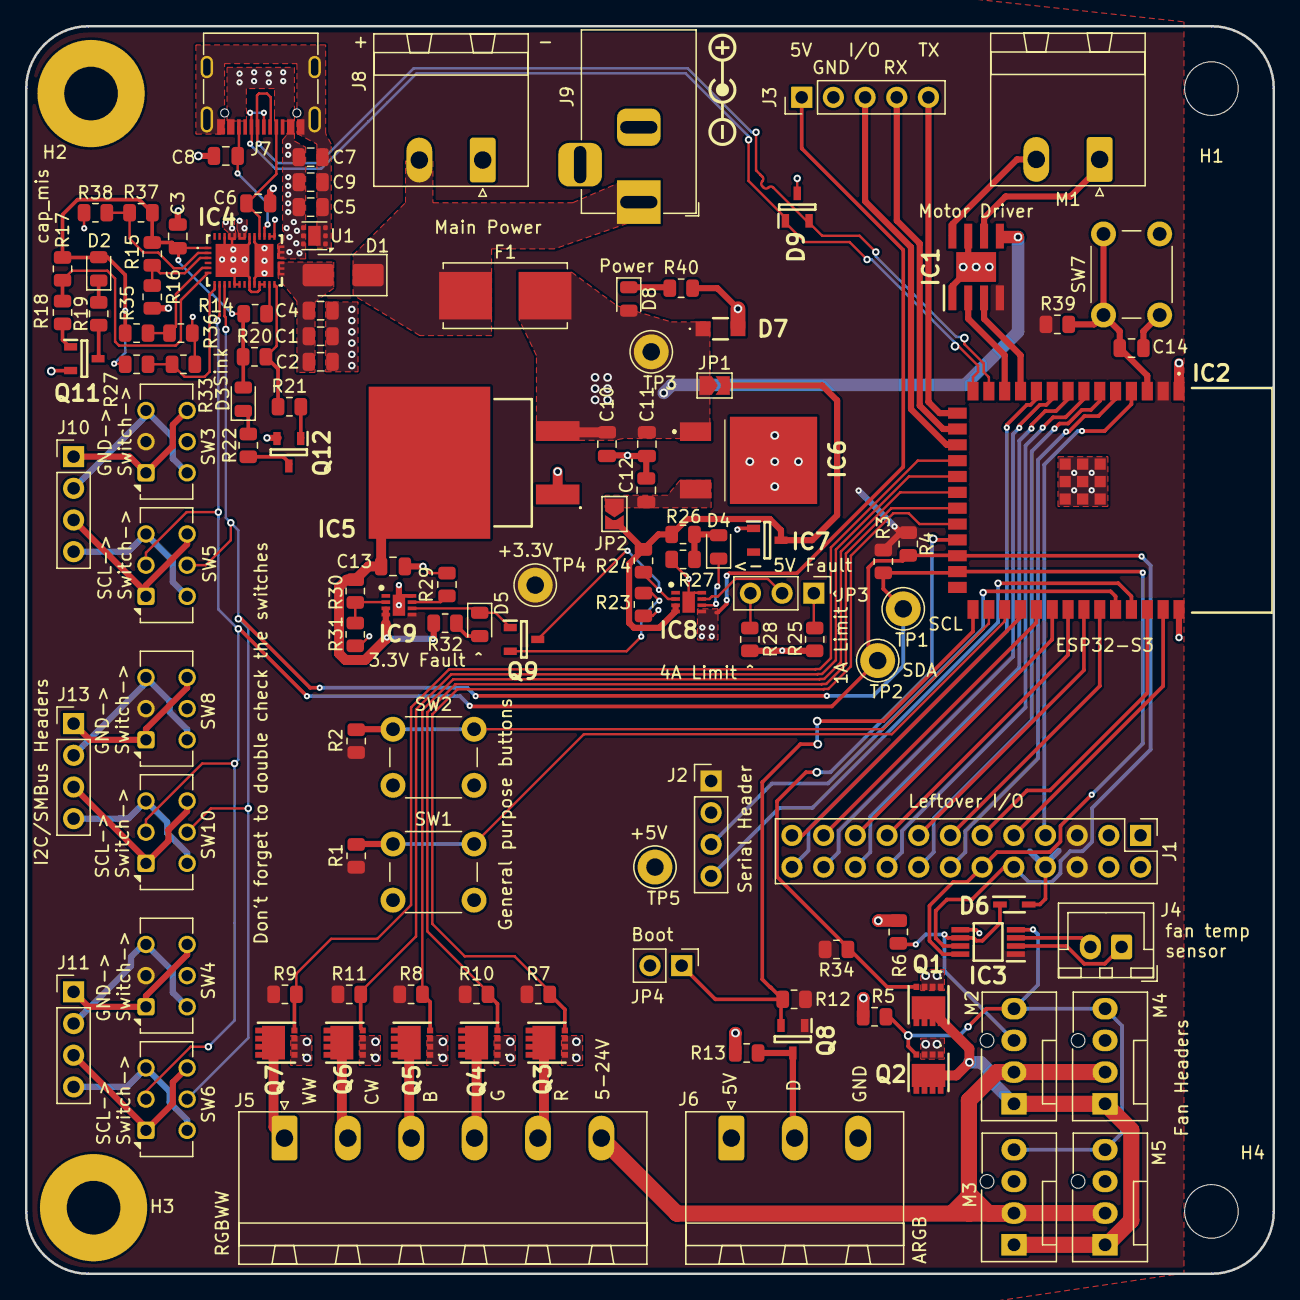
[picture p31: board ESPHome AIO.kicad_pcb from above]

Board: 2 copper layers, 100.0 x 100.0 mm, 125 parts (0 on the bottom side), 100 nets.

Other parts of the board:
R27#2: 10K; R_0805_2012Metric
