Ian-Blockmans/ESPHhome-AIO/(commit log)

2024-02-17 for first upload
    [ESPHome AIO.kicad_pcb, ESPHome AIO.kicad_sch, FanHeaders.kicad_sch, I2C.kicad_sch, RGB.kicad_sch, SignalLed.kicad_sch, USB.kicad_sch, power.kicad_sch]
2024-02-19 start pcb
    [ESPHome AIO.kicad_pcb, ESPHome AIO.kicad_sch, FanHeaders.kicad_sch, I2C.kicad_sch, RGB.kicad_sch, SignalLed.kicad_sch, USB.kicad_sch, power.kicad_sch]
2024-02-19 done for the day
    [ESPHome AIO.kicad_pcb, ESPHome AIO.kicad_sch, I2C.kicad_sch, USB.kicad_sch]
2024-02-23 posible V0.1
    [ESPHome AIO.kicad_pcb, ESPHome AIO.kicad_sch, I2C.kicad_sch, SignalLed.kicad_sch, USB.kicad_sch]
2024-06-04 v0.1 prototype ordered
    [BOM-ESPHome AIO.csv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]
2024-06-18 V0.2 maybe
    [ESPHome AIO.csv, ESPHome AIO.kicad_pcb, ESPHome AIO.kicad_sch, FanHeaders.kicad_sch, SignalLed.kicad_sch, USB.kicad_sch, power.kicad_sch]
2024-07-01 V0.2 wip
    [ESPHome AIO.kicad_sch, FanHeaders.kicad_sch, SignalLed.kicad_sch, USB.kicad_sch, power.kicad_sch]
